robsaddler/BreakBeam/ciseco-master/Ciseco-Eagle-Designs-master/R016 - Slice of Radio/R016 - Slice of Radio v1.1.brd

## EAGLE design ciseco-master/Ciseco-Eagle-Designs-master/R016 - Slice of Radio/R016 - Slice of Radio v1.1.brd (2026-09-29)

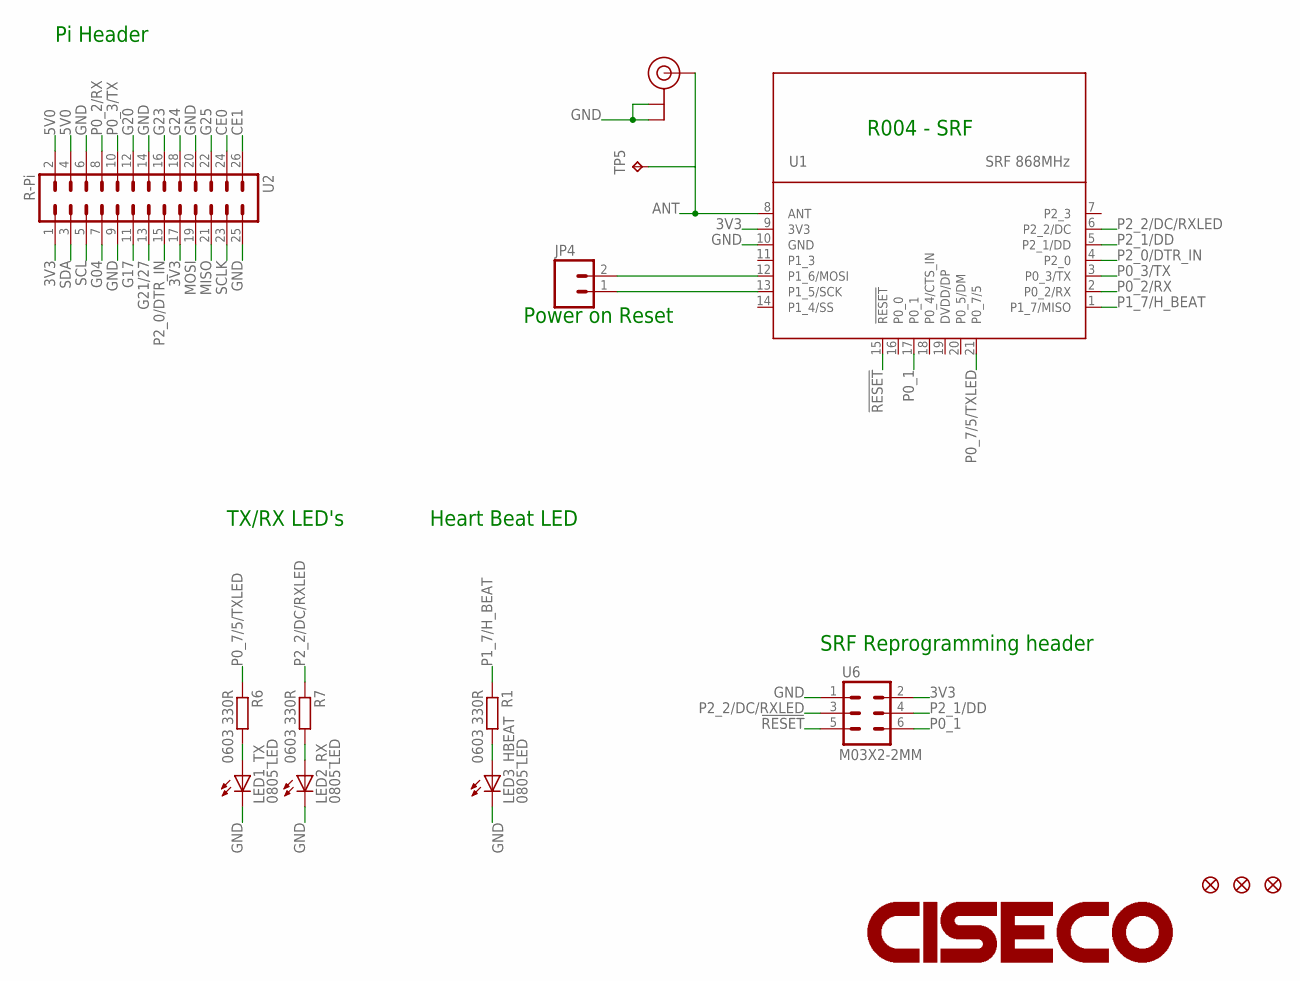
[picture p40: schematic R016 - Slice of Radio v1.1.sch]

Parts:
JP1, JP2, JP3: FIDUCIAL1X2.5-STOP; FIDUCIAL-1X2.5-STOP
JP4: M02PTH; 1X02
LED1_TX, LED2_RX, LED3_HBEAT: 0805 LED; LED-0805-CORRECT
LOGO1: CISECOLOGO-2MM; CISECO-2MM
R1, R6, R7: 0603 330R; C0603K-SMALL
TP5: TPPAD1-13; P1-13
U1: SRF 868MHz; SRF-LANDING-1.2
U2: R-Pi; EVE-BOARD-REF-LOCK
U6: M03X2-2MM; 2X3_2MM
U11: U.FL 868; U.FL

Connections:
3V3: U1.9 (3V3), U2.1, U2.17, U6.2
5V0: U2.2, U2.4
!RESET: U1.15 (!RESET), U6.5
ANT: TP5.TP, U1.8 (ANT), U11.P$3 (SIGNAL)
CE0: U2.24
CE1: U2.26
G04: U2.7
G17: U2.11
G20: U2.12
G21/27: U2.13
G23: U2.16
G24: U2.18
G25: U2.22
GND: LED1_TX.C, LED2_RX.C, LED3_HBEAT.C, U1.10 (GND), U2.6, U2.9, U2.14, U2.20, U2.25, U6.1, U11.P$1 (GND), U11.P$2 (GND)
MISO: U2.21
MOSI: U2.19
unnamed: LED3_HBEAT.A, R1.2
unnamed: JP4.1, U1.13 (P1_5/SCK)
unnamed: JP4.2, U1.12 (P1_6/MOSI)
unnamed: LED2_RX.A, R7.2
unnamed: LED1_TX.A, R6.2
P0_1: U1.17 (P0_1), U6.6
P0_2/RX: U1.2 (P0_2/RX), U2.8
P0_3/TX: U1.3 (P0_3/TX), U2.10
P0_7/5/TXLED: R6.1, U1.21 (P0_7/5)
P1_7/H_BEAT: R1.1, U1.1 (P1_7/MISO)
P2_0/DTR_IN: U1.4 (P2_0), U2.15
P2_1/DD: U1.5 (P2_1/DD), U6.4
P2_2/DC/RXLED: R7.1, U1.6 (P2_2/DC), U6.3
SCL: U2.5
SCLK: U2.23
SDA: U2.3

Notes on the sheet:
Power on Reset
Pi Header
SRF Reprogramming header
TX/RX LED's
Heart Beat LED
R004 - SRF

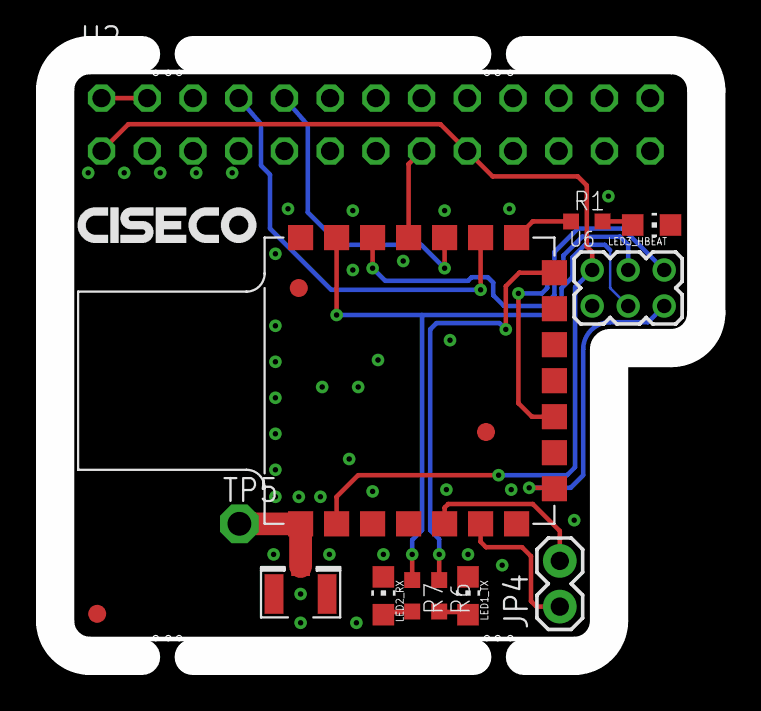
[picture p41: board R016 - Slice of Radio v1.1.brd from above]

Board: 2 copper layers, 36.3 x 33.5 mm, 18 parts (1 on the bottom side), 18 nets.

Other parts of the board:
U$4: WEEE-LOGO
U$5: PIBOW
