robsaddler/BreakBeam/ciseco-master/Ciseco-Eagle-Designs-master/R017 - SRF Shield/R017 - SRF-Shield v1.0.brd

## EAGLE design ciseco-master/Ciseco-Eagle-Designs-master/R017 - SRF Shield/R017 - SRF-Shield v1.0.brd (2026-09-29)

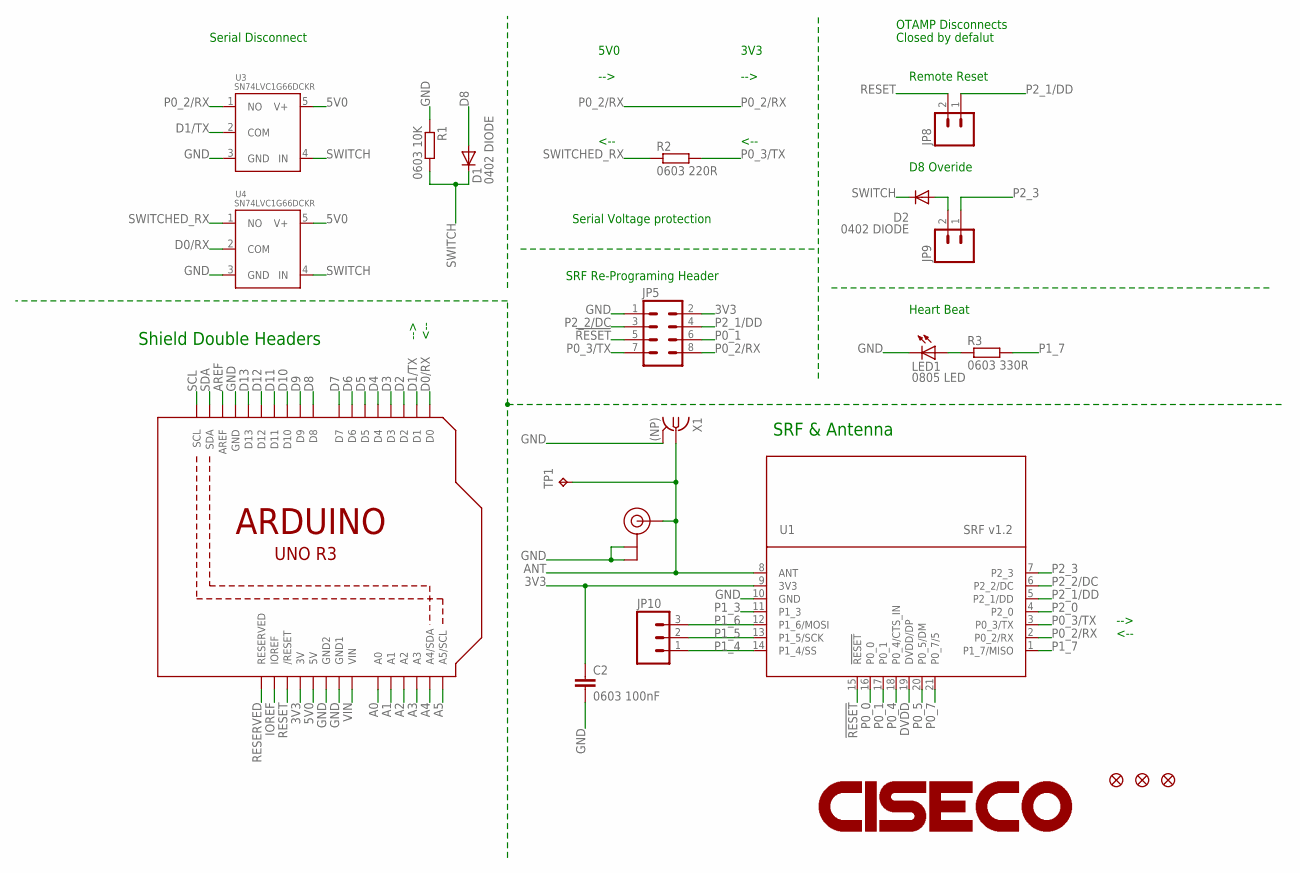
[picture p42: schematic R017 - SRF-Shield v1.0.sch]

Parts:
C2: 0603 100nF; C0402-NARROW
D1, D2: 0402 DIODE; D0402-NARROW
JP4, JP6, JP7: FIDUCIAL1X2.5-STOP; FIDUCIAL-1X2.5-STOP
JP5: M04X2; 2X4
JP8, JP9: M02PTH; 1X02
JP10: M03PTH; 1X03
LED1: 0805 LED; LED-0805-1206
R1: 0603 10K; C0603K-SMALL
R2: 0603 220R; C0603K-SMALL
R3: 0603 330R; C0603K-SMALL
TP1: TPPAD1-13; P1-13
U1: SRF v1.2; SRF-LANDING-1.0A-MOVE
U2: ARDUINOR3-DOUBL-OFFSET; ARDUINOR3-DOUBLE-OFFSET
U3, U4: SN74LVC1G66DCKR; SC70
U5: U.FL (NP); U.FL
U$3: CISECO-LARGE; CISECO-4MM
X1: (NP); J502-ND-142-0711-821/826-LWK1

Connections:
3V3: C2.1, JP5.2, U1.9 (3V3), U2.3V, U2.3V1 (3V)
5V0: U2.5V, U2.5V1 (5V), U3.5 (V+), U4.5 (V+)
!RESET: JP5.5, U1.15 (!RESET)
A0: U2.A0, U2.A6 (A0)
A1: U2.A1, U2.A7 (A1)
A2: U2.A2, U2.A8 (A2)
A3: U2.A3, U2.A9 (A3)
A4: U2.A4 (A4/SDA), U2.A10 (A4/SDA)
A5: U2.A5 (A5/SCL), U2.A11 (A5/SCL)
ANT: TP1.TP, U1.8 (ANT), U5.P$3 (SIGNAL), X1.1
AREF: U2.AREF, U2.AREF1 (AREF)
D0/RX: U2.D0, U2.D18 (D0), U4.2 (COM)
D1/TX: U2.D1, U2.D17 (D1), U3.2 (COM)
D2: U2.D2, U2.D16 (D2)
D3: U2.D3, U2.D15 (D3)
D4: U2.D4, U2.D14 (D4)
D5: U2.D5, U2.D19 (D5)
D6: U2.D6, U2.D20 (D6)
D7: U2.D7, U2.D21 (D7)
D8: D1.A, U2.D8, U2.D22 (D8)
D9: U2.D9, U2.D23 (D9)
D10: U2.D10, U2.D24 (D10)
D11: U2.D11, U2.D25 (D11)
D12: U2.D12, U2.D26 (D12)
D13: U2.D13, U2.D27 (D13)
DVDD: U1.19 (DVDD/DP)
GND: C2.2, JP5.1, LED1.C, R1.1, U1.10 (GND), U2.GND, U2.GND1, U2.GND2, U2.GND3 (GND1), U2.GND4 (GND2), U2.GND5 (GND), U3.3 (GND), U4.3 (GND), U5.P$1 (GND), U5.P$2 (GND), X1.G@1 (GND), X1.G@2 (GND), X1.G@3 (GND), X1.G@4 (GND)
IOREF: U2.IOREF, U2.IOREF1 (IOREF)
unnamed: LED1.A, R3.1
OTAMP_M: D2.A, JP9.2
P0_0: U1.16 (P0_0)
P0_1: JP5.6, U1.17 (P0_1)
P0_2/RX: JP5.8, U1.2 (P0_2/RX), U3.1 (NO)
P0_3/TX: JP5.7, R2.2, U1.3 (P0_3/TX)
P0_4: U1.18 (P0_4/CTS_IN)
P0_5: U1.20 (P0_5/DM)
P0_7: U1.21 (P0_7/5)
P1_3: U1.11 (P1_3)
P1_4: JP10.1, U1.14 (P1_4/SS)
P1_5: JP10.2, U1.13 (P1_5/SCK)
P1_6: JP10.3, U1.12 (P1_6/MOSI)
P1_7: R3.2, U1.1 (P1_7/MISO)
P2_0: U1.4 (P2_0)
P2_1/DD: JP5.4, JP8.1, U1.5 (P2_1/DD)
P2_2/DC: JP5.3, U1.6 (P2_2/DC)
P2_3: JP9.1, U1.7 (P2_3)
RESERVED: U2.RESERVED, U2.RESERVED1 (RESERVED)
RESET: JP8.2, U2.RESET (/RESET), U2.RESET1 (/RESET)
SCL: U2.SCL, U2.SCL1 (SCL)
SDA: U2.SDA, U2.SDA1 (SDA)
SWITCH: D1.C, D2.C, R1.2, U3.4 (IN), U4.4 (IN)
SWITCHED_RX: R2.1, U4.1 (NO)
VIN: U2.VIN, U2.VIN1 (VIN)

Notes on the sheet:
SRF Re-Programing Header
5V0
3V3
Remote Reset
Heart Beat
Closed by defalut
OTAMP Disconnects
Serial Voltage protection
Serial Disconnect
<--
-->
D8 Overide
Shield Double Headers
SRF & Antenna

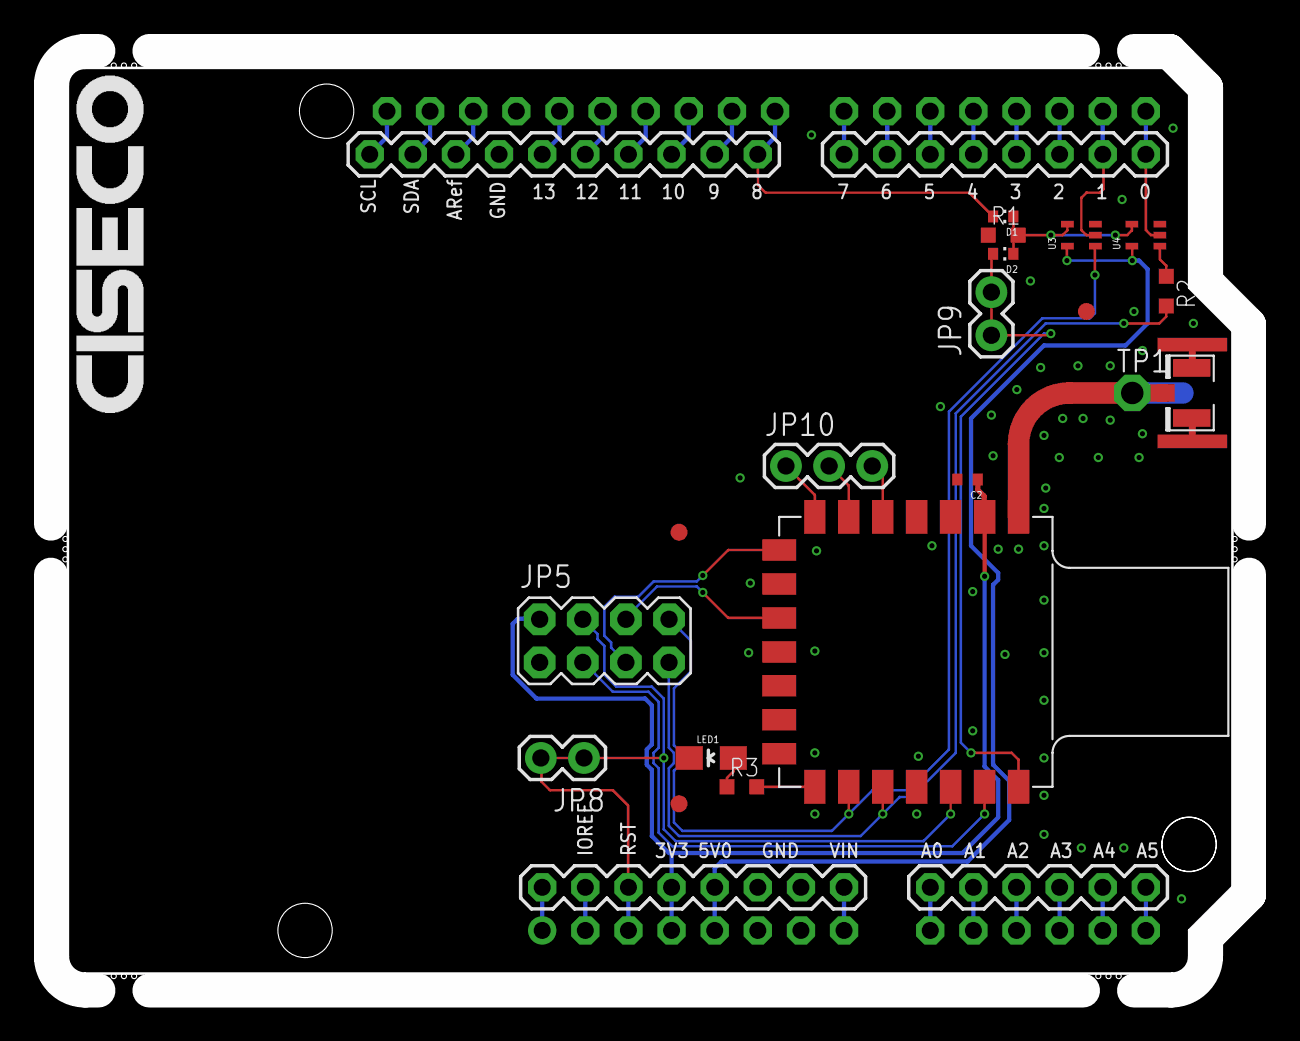
[picture p43: board R017 - SRF-Shield v1.0.brd from above]

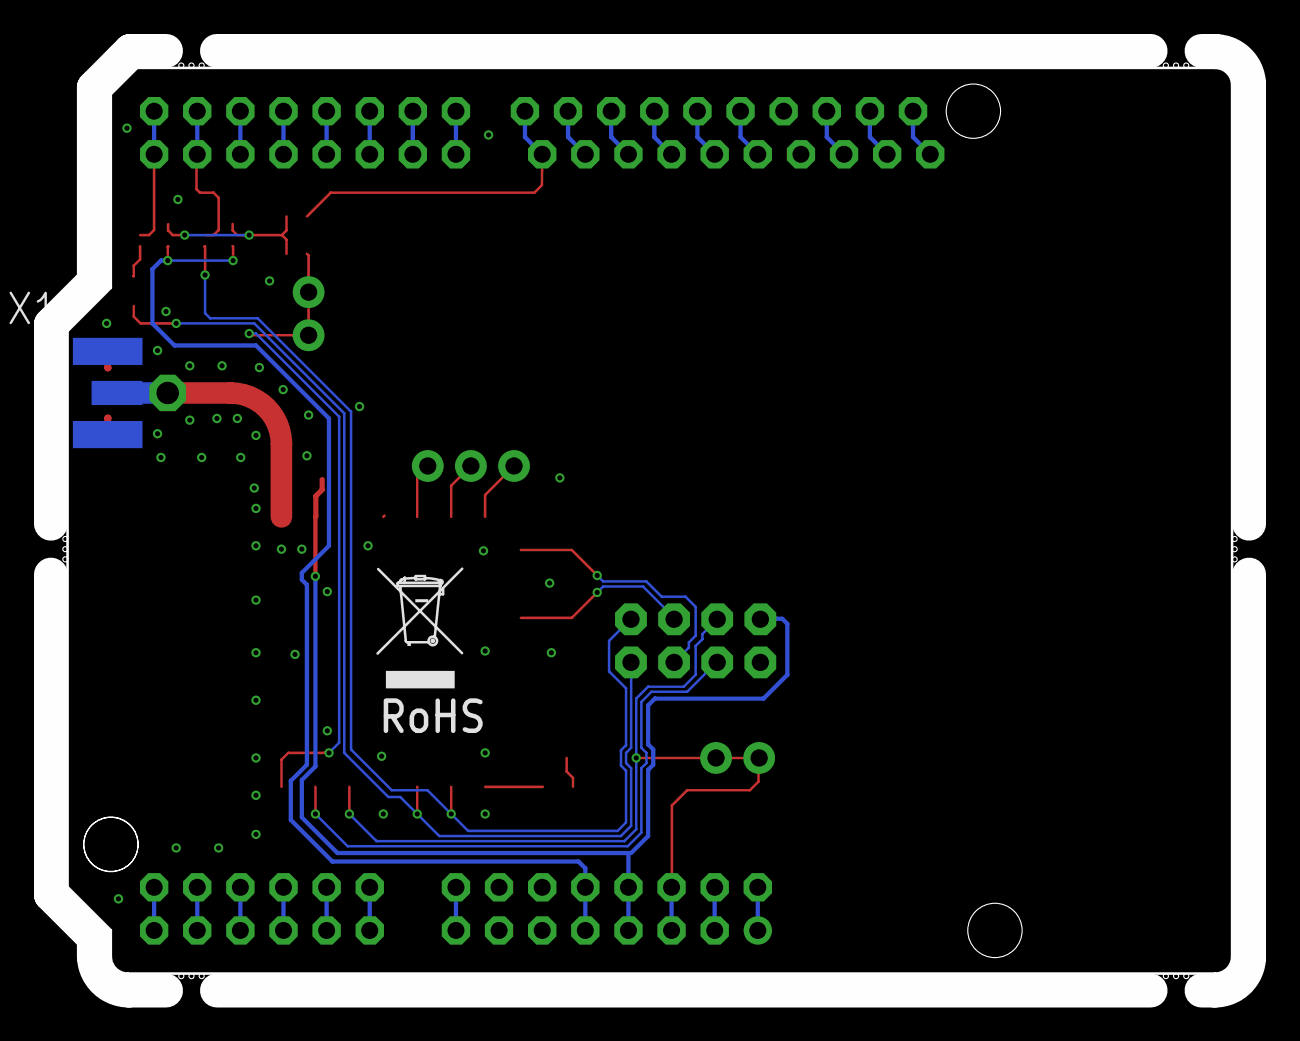
[picture p44: board R017 - SRF-Shield v1.0.brd from below]

Board: 2 copper layers, 70.6 x 55.4 mm, 23 parts (2 on the bottom side), 46 nets.

Other parts of the board:
U$6: WEEE-LOGO
