robsaddler/BreakBeam/ciseco-master/Ciseco-Eagle-Designs-master/B008 - Xino RF/Xino RF v1.3.brd

## EAGLE design ciseco-master/Ciseco-Eagle-Designs-master/B008 - Xino RF/Xino RF v1.3.brd (2026-09-29)

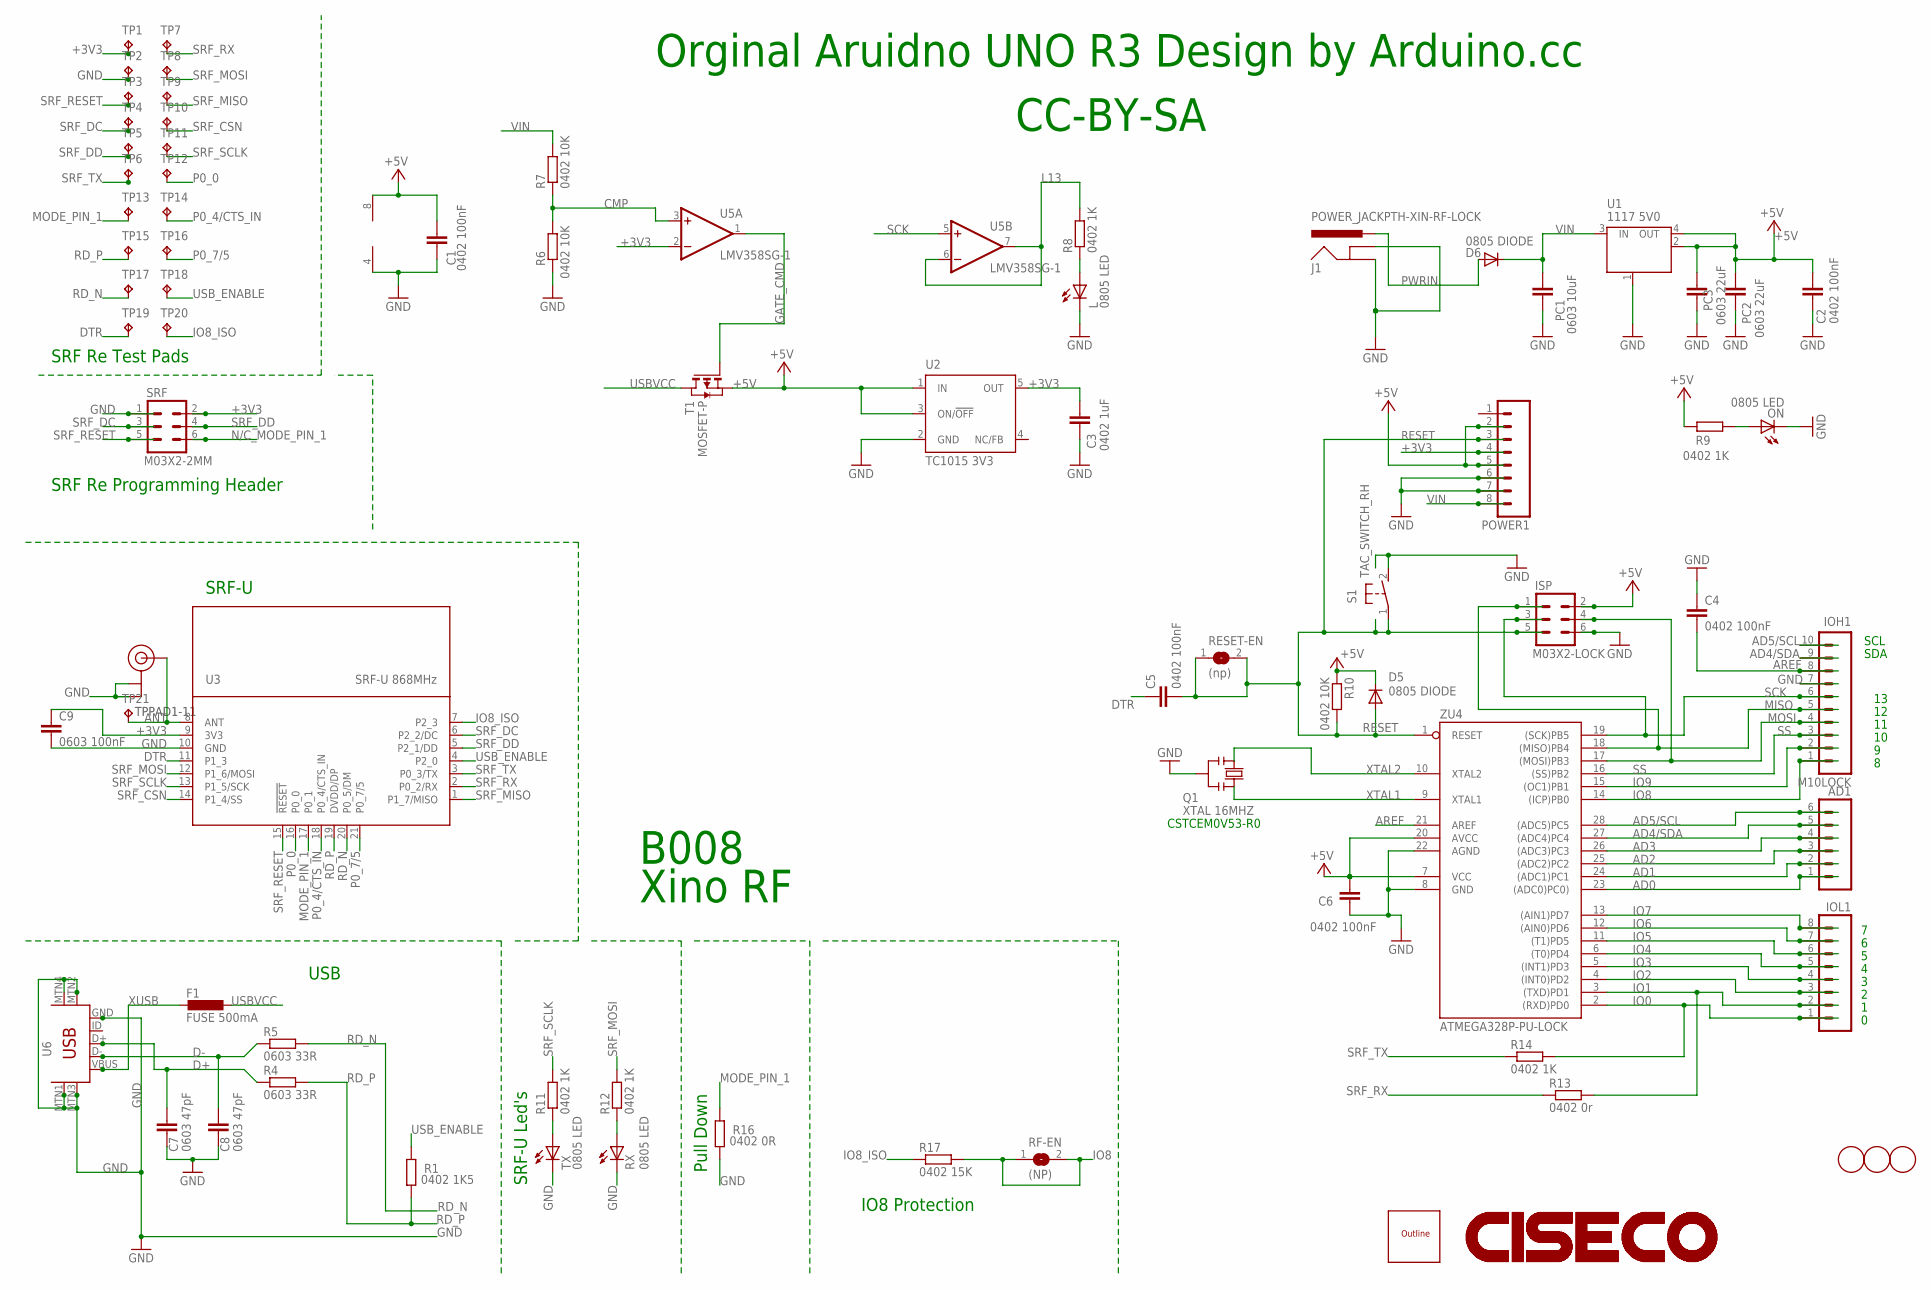
[picture p45: schematic Xino RF v1.3.sch]

Parts:
AD1: M06LOCK; 1X06_LOCK
C1, C2, C4, C5: 0402 100nF; C0402-SMALLER
C3: 0402 1uF; C0402-SMALLER
C6: 0402 100nF; C0603-ROUND
C7, C8: 0603 47pF; C0603K-SMALL
C9: 0603 100nF; C0402-SMALLER
D5, D6: 0805 DIODE; 0805-DIODE
F1: FUSE 500mA; L1812
FD1, FD2, FD3: FIDUCIALMOUNT; FIDUCIA-MOUNT
IOH1: M10LOCK; 1X10_LOCK
IOL1: M08LOCK; 1X08_LOCK
ISP: M03X2-LOCK; 2X3_LOCK
J1: POWER_JACKPTH-XIN-RF-LOCK; POWER_JACK_PTH_XINO_RF_LOCK
L: 0805 LED; LED-0805-1206
ON: 0805 LED; LED-0805-1206
PC1: 0603 10uF; C0805K
PC2, PC3: 0603 22uF; C0805K
POWER1: M08LOCK; 1X08_LOCK
Q1: XTAL 16MHZ; RESONATOR
R1: 0402 1K5; R0402-SMALLER
R4, R5: 0603 33R; C0603K-SMALL
R6, R7, R10: 0402 10K; R0402-SMALLER
R8, R9, R11, R12, R14: 0402 1K; R0402-SMALLER
R13: 0402 0r; R0402-SMALLER
R16: 0402 0R; R0402-SMALLER
R17: 0402 15K; R0402-SMALLER
RESET-EN: (np); SJ
RF-EN: (NP); SJ
RX: 0805 LED; LED-0805-1206
S1: TAC_SWITCH_RH; B3F-31XX
SRF: M03X2-2MM; 2X3_2MM
T1: MOSFET-P; SOT-23
TP1, TP2, TP3, TP4, TP5, TP6, TP7, TP8, TP9, TP10, TP11, TP12, TP13, TP14, TP15, TP16, TP17, TP18, TP19, TP20: TPB1,27; B1,27
TP21: TPPAD1-11; P1-11
TX: 0805 LED; LED-0805-1206
U1: 1117 5V0; SOT223
U2: TC1015 3V3; SOT23-DBV
U3: SRF-U 868MHz; SRF-LANDING-1.2
U5: LMV358SG-1; SO08
U6: USB-MINIB-5PIN; USB-MINIB-CISECO-1
U11: U.FL 868; U.FL
U$1: CISECO-MEDIUM; CISECO-1.3MM
U$2: ARDUINO-OUTLINE-MILL
U$3: CISECO-LARGE; CISECO-4MM
ZU4: ATMEGA328P-PU-LOCK; DIL28-3-LOCK

Connections:
+3V3: C3.2, C9.1, POWER1.4, SRF.2, TP1.TP, U2.5 (OUT), U3.9 (3V3), U5.2 (-IN)
+5V: C1.2, C2.2, C6.2, D5.C, ISP.2, PC2.1, PC3.1, POWER1.2, POWER1.5, R9.2, R10.1, T1.2 (S), U1.2 (OUT), U1.4 (OUT), U2.1 (IN), U2.3 (ON/!OFF), U5.8 (V+), ZU4.7 (VCC), ZU4.20 (AVCC)
AD0: AD1.1, ZU4.23 ((ADC0)PC0))
AD1: AD1.2, ZU4.24 ((ADC1)PC1)
AD2: AD1.3, ZU4.25 ((ADC2)PC2)
AD3: AD1.4, ZU4.26 ((ADC3)PC3)
AD4/SDA: AD1.5, IOH1.9, ZU4.27 ((ADC4)PC4)
AD5/SCL: AD1.6, IOH1.10, ZU4.28 ((ADC5)PC5)
ANT: TP21.TP, U3.8 (ANT), U11.P$3 (SIGNAL)
AREF: C4.2, IOH1.8, ZU4.21 (AREF)
CMP: R6.2, R7.1, U5.3 (+IN)
D+: C7.1, R4.1, U6.D+
D-: C8.1, R5.1, U6.D-
DTR: C5.1, TP19.TP, U3.11 (P1_3)
GATE_CMD: T1.3 (G), U5.1 (OUT)
GND: C1.1, C2.1, C3.1, C4.1, C6.1, C7.2, C8.2, C9.2, IOH1.7, ISP.6, J1.GND, J1.GNDBREAK, L.C, ON.C, PC1.2, PC2.2, PC3.2, POWER1.6, POWER1.7, Q1.2, R6.1, R16.1, RX.C, S1.2 (S), SRF.1, TP2.TP, TX.C, U1.1 (GND/ADJ), U2.2 (GND), U3.10 (GND), U5.4 (V-), U6.GND, U6.MTN1 (MTN2), U6.MTN2 (MTN3), U6.MTN3 (MTN1), U6.MTN4, U11.P$1 (GND), U11.P$2 (GND), ZU4.8 (GND), ZU4.22 (AGND)
IO0: IOL1.1, R14.2, ZU4.2 ((RXD)PD0)
IO1: IOL1.2, R13.2, ZU4.3 ((TXD)PD1)
IO2: IOL1.3, ZU4.4 ((INT0)PD2)
IO3: IOL1.4, ZU4.5 ((INT1)PD3)
IO4: IOL1.5, ZU4.6 ((T0)PD4)
IO5: IOL1.6, ZU4.11 ((T1)PD5)
IO6: IOL1.7, ZU4.12 ((AIN0)PD6)
IO7: IOL1.8, ZU4.13 ((AIN1)PD7)
IO8: IOH1.1, R17.2, RF-EN.1, RF-EN.2, ZU4.14 ((ICP)PB0)
IO8_ISO: R17.1, TP20.TP, U3.7 (P2_3)
IO9: IOH1.2, ZU4.15 ((OC1)PB1)
L13: R8.2, U5.6 (-IN), U5.7 (OUT)
MISO: IOH1.5, ISP.1, ZU4.18 ((MISO)PB4)
MODE_PIN_1: R16.2, TP13.TP, U3.17 (P0_1)
MOSI: IOH1.4, ISP.4, ZU4.17 ((MOSI)PB3)
unnamed: L.A, R8.1
unnamed: ON.A, R9.1
unnamed: R12.1, RX.A
unnamed: R11.1, TX.A
N/C_MODE_PIN_1: SRF.6
P0_0: TP12.TP, U3.16 (P0_0)
P0_4/CTS_IN: TP14.TP, U3.18 (P0_4/CTS_IN)
P0_7/5: TP16.TP, U3.21 (P0_7/5)
PWRIN: D6.A, J1.PWR
RD_N: R5.2, TP17.TP, U3.20 (P0_5/DM)
RD_P: R1.1, R4.2, TP15.TP, U3.19 (DVDD/DP)
RESET: C5.2, D5.A, ISP.5, POWER1.3, R10.2, RESET-EN.1, RESET-EN.2, S1.1, ZU4.1 (RESET)
SCK: IOH1.6, ISP.3, U5.5 (+IN), ZU4.19 ((SCK)PB5)
SRF_CSN: TP10.TP, U3.14 (P1_4/SS)
SRF_DC: SRF.3, TP4.TP, U3.6 (P2_2/DC)
SRF_DD: SRF.4, TP5.TP, U3.5 (P2_1/DD)
SRF_MISO: TP9.TP, U3.1 (P1_7/MISO)
SRF_MOSI: R12.2, TP8.TP, U3.12 (P1_6/MOSI)
SRF_RESET: SRF.5, TP3.TP, U3.15 (!RESET)
SRF_RX: R13.1, TP7.TP, U3.2 (P0_2/RX)
SRF_SCLK: R11.2, TP11.TP, U3.13 (P1_5/SCK)
SRF_TX: R14.1, TP6.TP, U3.3 (P0_3/TX)
SS: IOH1.3, ZU4.16 ((SS)PB2)
USBVCC: F1.1, T1.1 (D)
USB_ENABLE: R1.2, TP18.TP, U3.4 (P2_0)
VIN: D6.C, PC1.1, POWER1.8, R7.2, U1.3 (IN)
XTAL1: Q1.3, ZU4.9 (XTAL1)
XTAL2: Q1.1, ZU4.10 (XTAL2)
XUSB: F1.2, U6.VBUS

Notes on the sheet:
Xino RF
SDA
SCL
Pull Down
IO8 Protection
CC-BY-SA
Orginal Aruidno UNO R3 Design by Arduino.cc
USB
SRF Re Programming Header
SRF Re Test Pads
SRF-U
SRF-U Led's
B008
CSTCEM0V53-R0

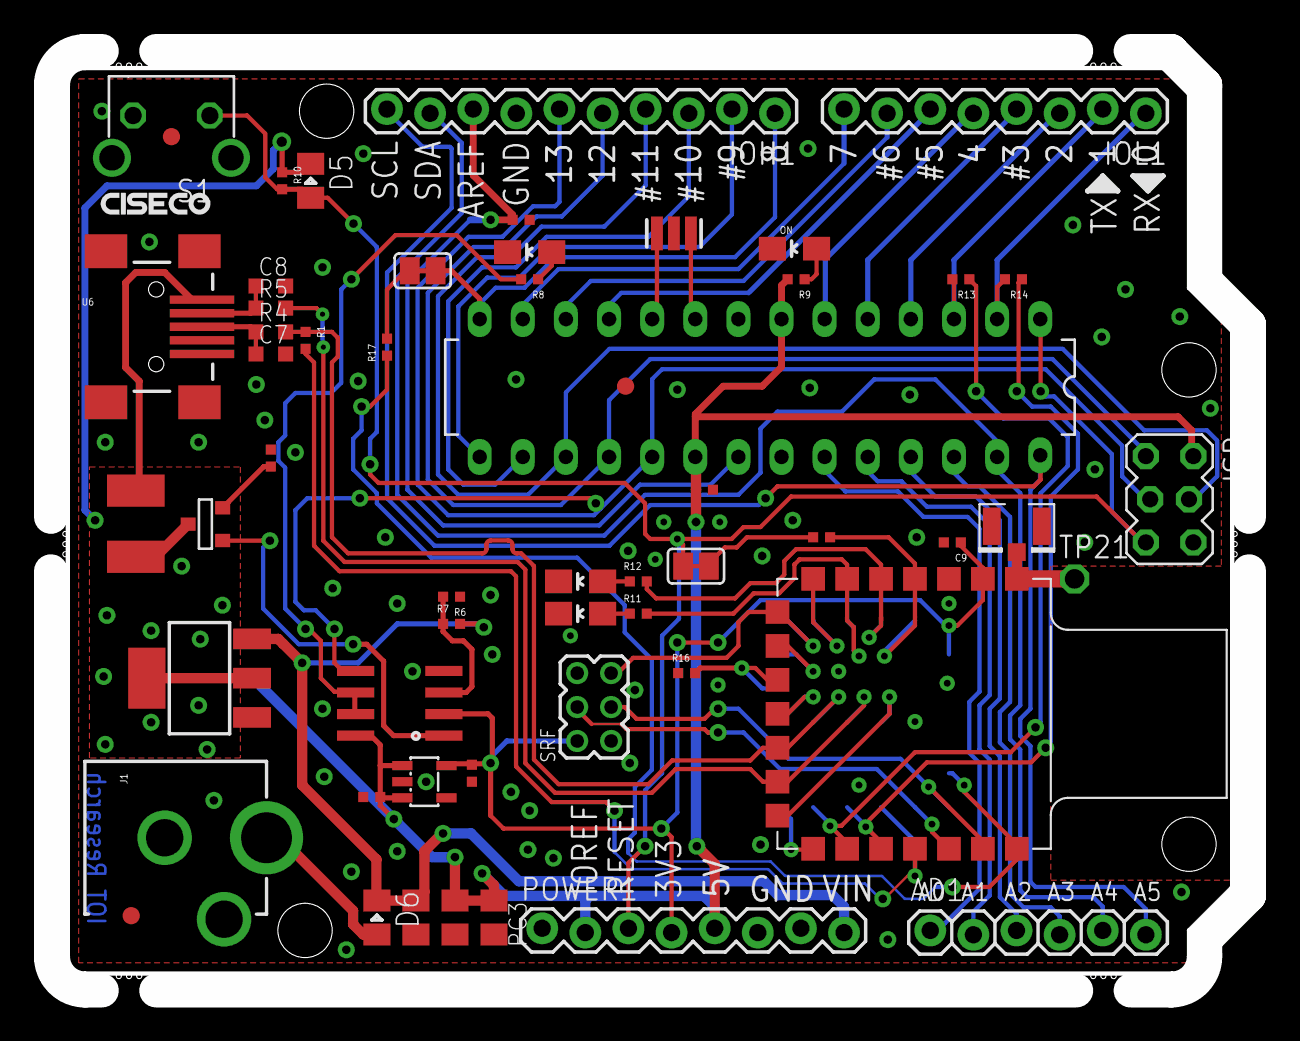
[picture p46: board Xino RF v1.3.brd from above]

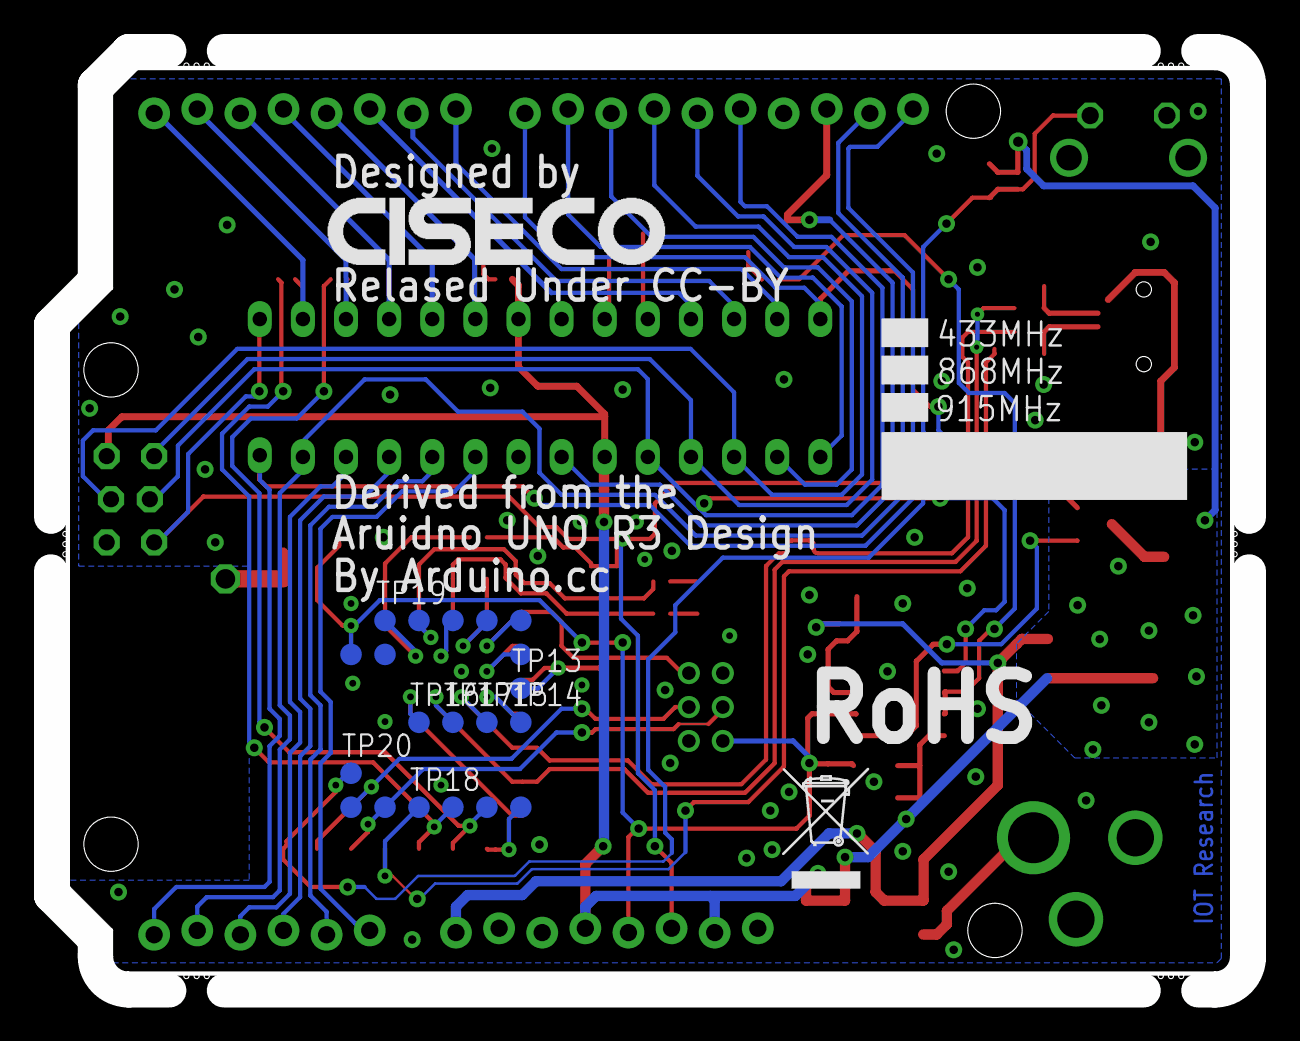
[picture p47: board Xino RF v1.3.brd from below]

Board: 2 copper layers, 70.6 x 55.4 mm, 80 parts (22 on the bottom side), 59 nets.

Other parts of the board:
U$4: WEEE-LOGO
