robsaddler/BreakBeam/(commit log)

2026-09-29 BreakBeam speed gates: firmware, PlatformIO project, build guide, Ciseco docs
    Phase 1 (radio link) verified 2026-09-28: both R017 SRF shields self-test OK
    at 115200 baud, finish gate polls start gate with 15-16 ms round trip.
    - BreakBeam/BreakBeam.ino: one firmware for both gates; role (start/finish)
    set once over USB serial and kept in EEPROM. Finish gate polls the start
    gate with 12-byte radio frames and places the start event on its own clock
    from the reported event age, so no clock sync is needed.
    - platformio.ini: builds the same sketch; also opens in Arduino IDE.
    - tools/gate.ps1: send commands to a gate and watch its output.
    - docs/GUIDE.md: beginner build guide, phase by phase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
    [R016 - Slice of Radio v1.1.brd, R016 - Slice of Radio v1.1.sch, R017 - SRF-Shield v1.0.brd, R017 - SRF-Shield v1.0.sch, Xino RF v1.3.brd, Xino RF v1.3.sch]
2026-09-30 Add solo role (both beams on one board) and four display drivers
    Phase 3 is blocked until stackable headers are soldered to the shields, because
    they have no sockets on top: a fitted shield leaves nowhere to plug a jumper.
    Solo role sidesteps that so the sensing and timing can be tested tonight.
    - role solo: A0 is the start beam, A1 the finish, joined by a long cable. The
    radio is left alone entirely, so no shield is needed. Lap mode still works for
    a single sensor.
    - BeamSensor is now a class, so two instances can watch two pins.
    - Displays, selected by "display <type>" and kept in EEPROM: 16x2 parallel LCD,
    16x2 on an I2C backpack (address auto-detected), TM1637 4-digit, MAX7219
    8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
2026-09-30 Phase 3 needs no soldering: the shield only uses six Arduino pins
    Read from the R017 schematic netlist in ciseco-master/: the SRF radio is wired to
    3V3, 5V, GND, D0, D1 and D8 only. Every other Arduino pin on the shield is a bare
    pass-through with nothing attached, so the shield does not have to sit on the Uno.
    Six female-to-male jumpers from the shield's pins to the Uno free every other pin
    for sensors and a display, which unblocks the two-gate build before the stackable
    headers arrive.
    Also recorded: the shield cannot go into a breadboard (pin rows ~48 mm apart
    against a breadboard's ~23 mm span, and the R3 half-pitch offset on the D8 row),
    and the footprint is ARDUINOR3-DOUBLE-OFFSET, so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
2026-10-03 Phase 2 rewritten around the parts in photos/, LCD data pins straight through
    Photos identified: a 1602A V2.0 with its 16-pin header already soldered (so it
    plugs into a breadboard with no soldering), a bare 2004A 20x4 and a bare 4-digit
    7-segment (both need soldering, so both skipped), several LDRs, three buzzers of
    unknown type, a Prototype Shield v.5, and Class III laser pens at 532 nm green
    and 650 nm red.
    - Firmware: the parallel LCD data pins were crossed over (LCD D4-D7 to Arduino
    D5-D2), which is easy to miswire by hand. Now straight through: LCD D4-D7 to
    Arduino D2-D5.
    - docs/GUIDE.md Phase 2 rewritten as a stage-by-stage bench build for those exact
    parts: laser safety, bread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
    [BreakBeam.ino]
2026-10-03 Phase 2 leads with the TEPT5700, not the LDR
    Starting on the LDR was over-cautious: neither sensor had been tested on this
    hardware, so the LDR was not a known-good baseline, and the firmware treats the
    two identically. Leading with the LDR just meant tuning the thresholds twice.
    - Parts table and Stage 3 now specify the phototransistor, including the polarity
    (long leg to the positive rail) that the LDR does not have, and the reassurance
    that reversed legs only give a dull reading because the 10k limits the current.
    - Stage 5 gains a table of expected readings. Pinned at 1023 with the laser on is
    correct and wanted, since the firmware only looks for a sudden fall; the case
    that nee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
2026-10-03 Add a plain-English glossary; the guide assumed terminology it should not
    Rob flagged that "jumper from the Uno's 5V to the + rail" assumes vocabulary he
    has never met. The guide was written at the wrong level in places, so it now
    opens with a glossary defining every term it uses before using it: jumper wire
    (and male vs female ends), breadboard, rail, row, pin, leg, GND, 5V, the analogue
    and digital pins, polarity, resistor colour bands, LDR, phototransistor,
    potentiometer, flashing, serial monitor, baud and firmware.
    Phase 2's breadboard explainer now points at the glossary rather than repeating a
    partial version of it.
2026-10-03 Use 330 ohm instead of 220 ohm, and say how exact resistor values must be
    Rob's assortment runs 10, 22, 47, 100, 150, 330, 470 and decade multiples, with no
    220 ohm in it. Every 220 ohm in the guide and the firmware comments is now 330 ohm,
    which he has.
    The guide also now says how close these values need to be, because it never did:
    the backlight and indicator-LED resistors only limit current, so anything from
    about 150 to 470 ohm works and the value just sets brightness. Only the sensor
    divider's 10 kohm affects behaviour, and that is adjustable too. The resistor
    colour-band table gained the values actually used: 150, 330, 470, 1k, 4.7k, 10k.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
2026-10-03 Stop naming an arbitrary breadboard row for the sensor
    "Row 10" was only ever an example, but the guide never said so, and Rob spotted
    that one of the LCD's own pins had landed in his row 10. Sharing that row would
    have wired the sensor's output straight onto an LCD data pin.
    The sensor connections are now described as "the sensor row", defined as any
    completely empty row, with the rule stated plainly: those three things share it
    and nothing else may be in it. The glossary entry for "row" now leads with the
    same rule, and adds that the channel down the middle splits every row in two, so
    the same number above and below it are separate rows.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
2026-10-03 Add a multimeter section, including that probe tips do not fit breadboard holes
    Debugging a dark LCD exposed two gaps. The guide told Rob to measure voltages
    without ever explaining how to set the meter up, and then told him to push the
    probe tips into breadboard holes, which does not work: a tip is about 2 mm across
    against a 0.6 mm hole, so it never reaches the clip inside and reads a false zero,
    and forcing it splays the clip and ruins the row.
    New section covers lead placement and the DC volts position, the warning about
    the A and mA sockets, using a spare jumper wire as a test point, the rule that
    voltage needs the power on while resistance and continuity need it off, and what
    a flat b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
2026-10-03 Fix the display test value, and separate the contrast and backlight circuits in the guide
    The "t" command said it was sending 12.34 but actually sent 1,234,000 microseconds,
    which the display correctly rendered as 1.23. The message was wrong, not the
    display. Now sends 12.34 s, which also exercises the tens digit.
    The guide listed the contrast pot and the backlight resistor adjacently in the pin
    table without saying they are independent circuits, so Rob wired LCD pin 15 to a
    pot leg. That feeds the backlight through the pot's whole 50k track, which passes
    so little current the screen stays dark and pin 15 reads near 0 V. The guide now
    draws the two circuits separately and says what that mis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
    [BreakBeam.ino]
2026-10-03 Phase 2 passed: first real times from the hardware
    On the board marked "start" (COM4), with a TEPT5700 and a 10k resistor: the beam
    reads 1022 with the red 650 nm laser on it and about 181 blocked, against roughly
    190 in room light alone. Three hand-waved lap times came out at 1.410 s, 0.821 s
    and 1.480 s, so the whole chain works end to end - laser, phototransistor,
    threshold, microsecond timing, LCD and serial.
    Also in this commit: "t" now re-initialises the display before testing, because a
    garbled screen is almost always one that lost its setup, and that gives a one-key
    fix. The guide records the measured numbers and two things that look like faults
    but are not: the sensor reads low in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
    [BreakBeam.ino]
2026-10-03 Make the single gate usable without a PC, and stop the display fighting back
    A long bench session on one gate turned up several real faults, all fixed here.
    - A beam that was never present could be "broken". An unconnected analogue pin
    drifts and mirrors its neighbour, so A1 stopped the clock the instant A0 started
    it, giving 0.000 s. A break now requires the beam to have been there first.
    - Lap mode was lost on every reset, and opening the serial port resets the board,
    so it kept turning itself off. Now kept in EEPROM.
    - Lap mode restarted the clock on the same break that stopped it, so the result
    was wiped after a single frame and could never be read. It now stops and holds;
    the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
    [BreakBeam.ino]
2026-10-03 Always drive D8; a floating radio-enable corrupts serial and blocks uploads
    With a shield attached, leaving D8 as an input leaves the two TS5A1066 analogue
    switches half open. That couples the radio onto the D0/D1 lines it shares with
    USB, mangling characters in both directions, so commands were silently lost and
    avrdude could not talk to the bootloader at all.
    The firmware only ever set D8 in the start and finish roles, so solo mode left it
    floating. It is now always an output: high when the radio is wanted, low
    otherwise. Recovery if you meet it on an older build: pull the D0 and D1 jumpers,
    upload, reconnect.
    Gate two is complete with this: radio self-test passes at 115200 over six
    fema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
2026-10-03 Phase 3 passed: first wireless start-to-finish time
    Two gates, two lasers, two phototransistors, a radio link and a display. The start
    event crossed the room by radio and was placed on the finish gate's clock to within
    8 ms; the first full time came out at 4.095 s with the link at 16 ms round trip.
    Both shields are connected by six female-to-male jumpers, so no soldering was
    needed after all.
    Lap mode is now a solo-role feature only. The finish gate has a start gate to
    listen to, so timing its own beam twice was never meaningful, and worse, the
    setting could not be turned off reliably: a command typed at the finish gate
    shares the serial line with ten radio polls a second and is usually shr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
2026-10-03 Fix a timer underflow that abandoned every run on the tick it started
    finishGateLoop sampled millis() at the top of the iteration, then a radio reply
    arriving later in the same iteration stamped runStartMs with a fresh millis().
    When a millisecond ticked over in between, the start was fractionally ahead of the
    loop's own clock and "nowMs - runStartMs" wrapped to about four billion, sailing
    past the sixty second limit and binning the run immediately. The symptom was a
    gate that announced "START! clock running" and was back to ARMED on the next line,
    intermittently, because it depended on exactly when the millisecond boundary fell.
    All the elapsed-time tests in both loops now go through an el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
    [BreakBeam.ino]
2026-10-03 Add Phase 4: the permanent build, written to be designed around
    Moves each gate off the breadboard onto a soldered prototype shield in a vertical
    stack, specified in enough detail that a case can be modelled around it.
    - Stack order is Uno, prototype shield, SRF radio on top. The radio goes on top
    because its own datasheet warns that covering the antenna section cuts range,
    and that order also means nothing stacks above it, so the stackable headers are
    not needed at all.
    - Guiding rule for the shield layout: anything that has to point somewhere lives
    on a lead, not on the board. Sockets rather than soldered-in components wherever
    a part might fail.
    - Power is one 9 V PP3 per gate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
2026-10-03 Rework Phase 4 for four tripods: a through-beam gate is four boxes, not two
    Rob has four tripods and is putting the laser on one and the Arduino on the other,
    across the lane. That is a through-beam gate, the arrangement commercial timing
    gates use and the more reliable of the two, but it invalidates the advice I had
    just written, which assumed laser and sensor shared a bracket.
    - Each gate is now two boxes: a sensor box with all the electronics, and a laser
    box containing only a laser, a battery and a switch.
    - The laser box must carry its own power. A cable across the lane is a trip hazard
    at hip height in front of sprinting athletes, so that is stated as a hard rule
    rather than a p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
2026-10-03 Laser end is a printed clamp for the existing pens, not a bought module
    Rob is keeping the laser pens, which already carry their own batteries. That makes
    each laser box simpler than what I had written: no module to buy, no battery, no
    switch, no electronics at all. Just a clamp with a tripod thread.
    The design note that matters is that the clamp should press the pen's button
    itself, via a thumbscrew bearing on it, which doubles as a genuine on/off control.
    Tape was what kept slipping during bench testing, and a printed part can do that
    job properly.
    Also specified: a split clamp with a pinch screw rather than a printed hole sized
    to grip, since a hole comes out a few tenths wrong and anyt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
2026-10-17 Give each event its own sound, and stop the tunes blocking the loop
    Rob has no buzzer wired yet and asked for start and finish to be audibly obvious
    rather than two similar beeps. The old scheme was 1500 Hz against 2000 Hz for
    60 ms against 80 ms, which is not tellable apart across a track.
    Events now have shapes rather than pitches: a rising fifth C6 to G6 means
    something has begun, the same fifth falling means it has finished, a climbing
    C6-G6-C7 means a time is ready, and two flat notes mean nothing happened. The
    finish gate also plays the start sound when the radio reports the far gate firing,
    so a coach standing at the finish hears the whole run: rising as they go, falling
    as they arri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
2026-10-28 Send the result back to the start gate so a screen there can show it
    The start gate never learns a time. It only knows its own beam broke; the finish
    gate does the arithmetic. A third frame now carries the answer back:
    "@T<run2><hundredths6>-", the same 12 bytes as the other two so the SRF sends it
    at once rather than holding it for a 16 ms timeout.
    Two things about how it is sent. It is queued rather than fired on the spot, and
    goes out only when the finish gate is not awaiting a reply, because the radio is
    half duplex and transmitting while the start gate was mid-reply would collide. And
    it repeats three times, since nothing acknowledges it and one lost frame would
    leave a stale time on t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
2026-10-29 Record the direction change to ESP32 in the project README
    Nothing has been soldered, so no work is lost. Noting here why the swap is worth
    making, since the reason is not the web app that prompted it: the Uno has one
    serial port shared between the radio and USB, and that is the root of most of the
    bugs this project has hit. An ESP32 has three, so the radio gets one to itself.
    Also records what carries over, which is nearly everything, and what is on hold:
    the prototype-shield assembly, and the case design, which was sized around a
    three-board stack that will no longer exist.
2026-10-29 Add the ESP32 bench test sketch and fix the pin map for a 30-pin DOIT board
    First code for the new board. Deliberately does three things and no more: proves
    the ESP32 flashes and talks to the PC, reads the beam sensor, and gets the SRF to
    answer on a serial port of its own. No timing logic until those three pass.
    Three constraints fixed the pin map. The sensors must sit on ADC1, because the
    other analogue bank stops working the moment wifi is on and wifi is the point of
    the exercise. GPIO 0, 2, 5, 12 and 15 decide how the chip boots, so nothing is
    wired to them; a display on one of those gives a board that sometimes will not
    start, which is a horrible fault to chase. And 21 and 22 are left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
