robsaddler/BreakBeam/(notices)

Notices in the files:
ciseco-master/Ciseco-Eagle-Designs-master/B008 - Xino RF/Xino RF v1.3.brd:
Relased Under CC-BY
parts and their libraries:
SparkFunJan12: Licensing: CC v3.0 Share-Alike You are welcome to use this library for commercial purposes.
