robsaddler/BreakBeam/photos/PXL_20261003_113512550.jpg

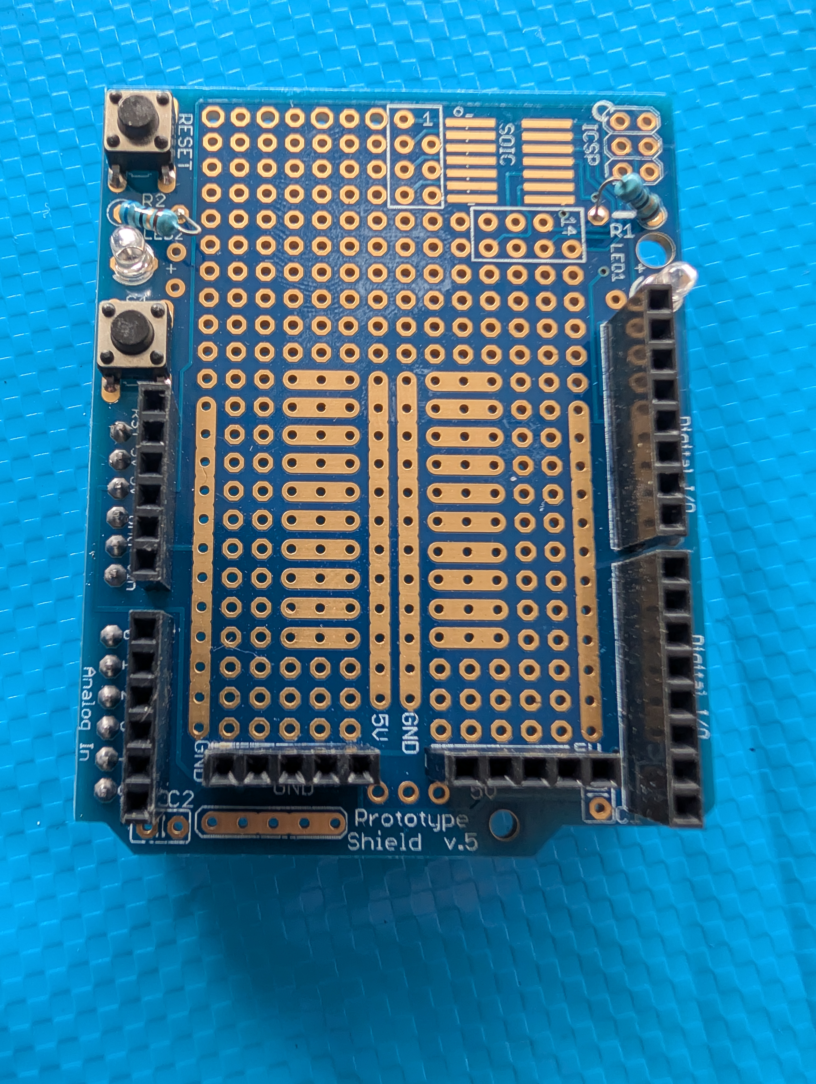
photos/PXL_20261003_113512550.jpg
