robsaddler/BreakBeam/photos/PXL_20261003_113529366.jpg

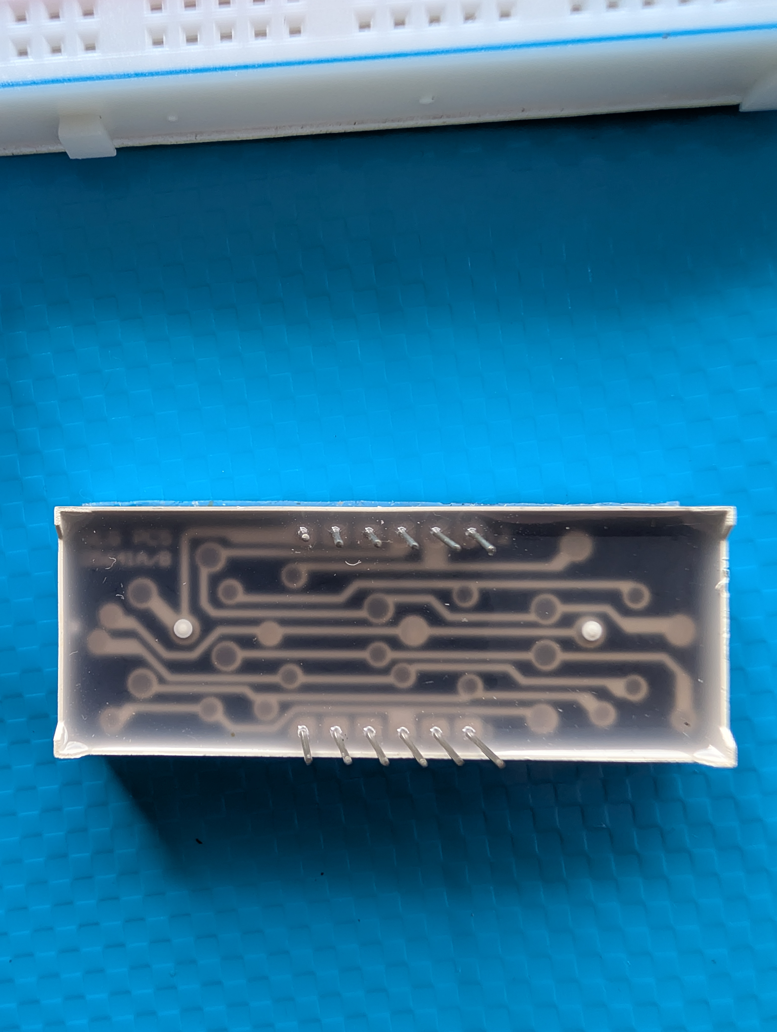
photos/PXL_20261003_113529366.jpg
