robsaddler/BreakBeam/photos/PXL_20261003_113542132.jpg

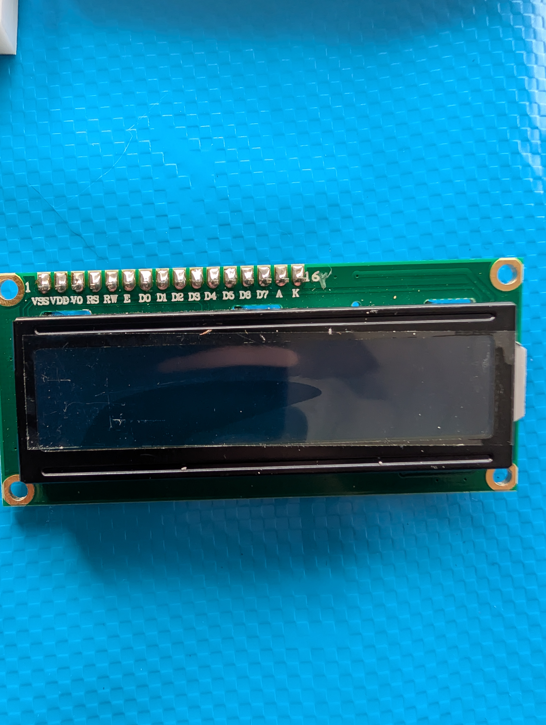
photos/PXL_20261003_113542132.jpg
