robsaddler/BreakBeam/photos/PXL_20261003_113548485.jpg

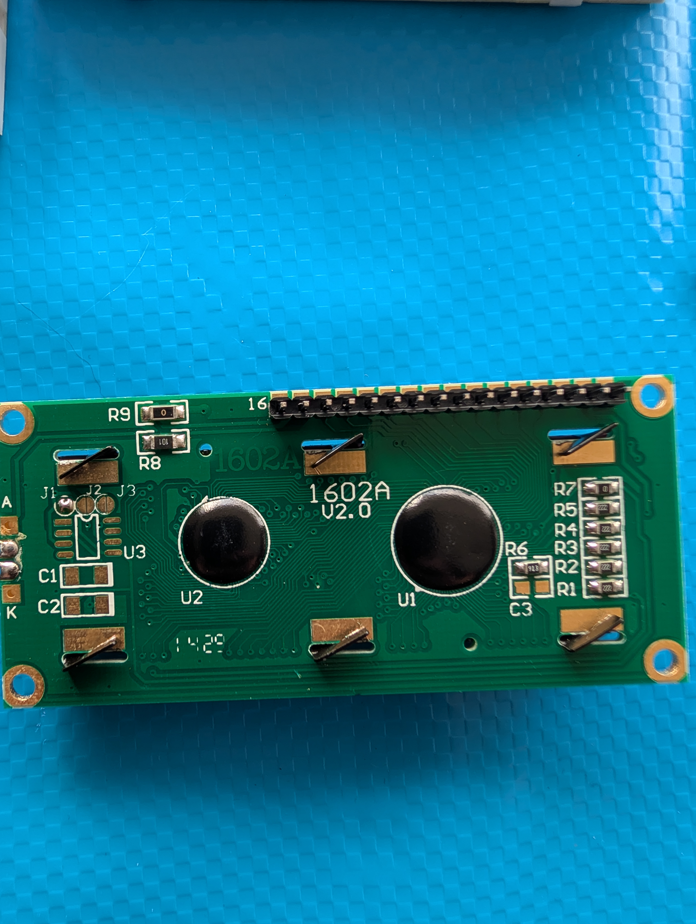
photos/PXL_20261003_113548485.jpg
