robsaddler/BreakBeam/photos/PXL_20261003_113816968.jpg

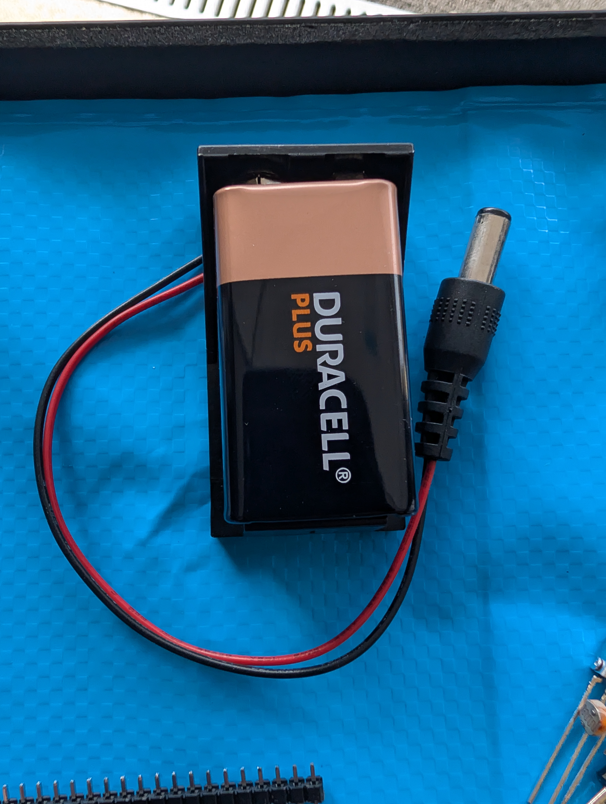
photos/PXL_20261003_113816968.jpg
