robsaddler/BreakBeam/photos/PXL_20261003_113824760.jpg

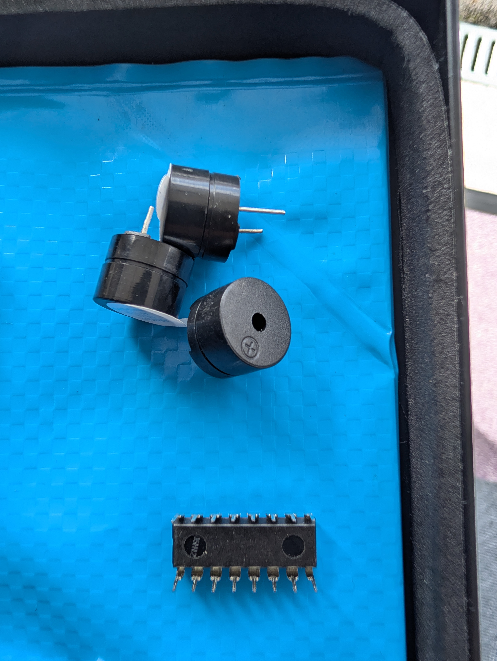
photos/PXL_20261003_113824760.jpg
