robsaddler/BreakBeam/photos/PXL_20261003_113829189.jpg

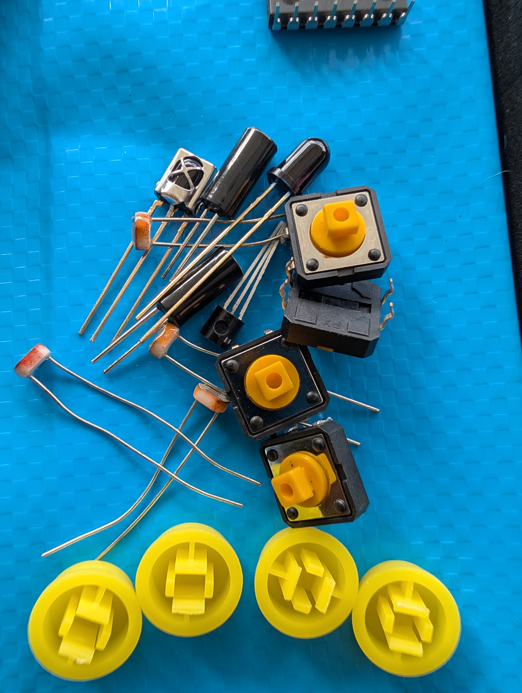
photos/PXL_20261003_113829189.jpg
