robsaddler/BreakBeam/photos/PXL_20261003_113833670.jpg

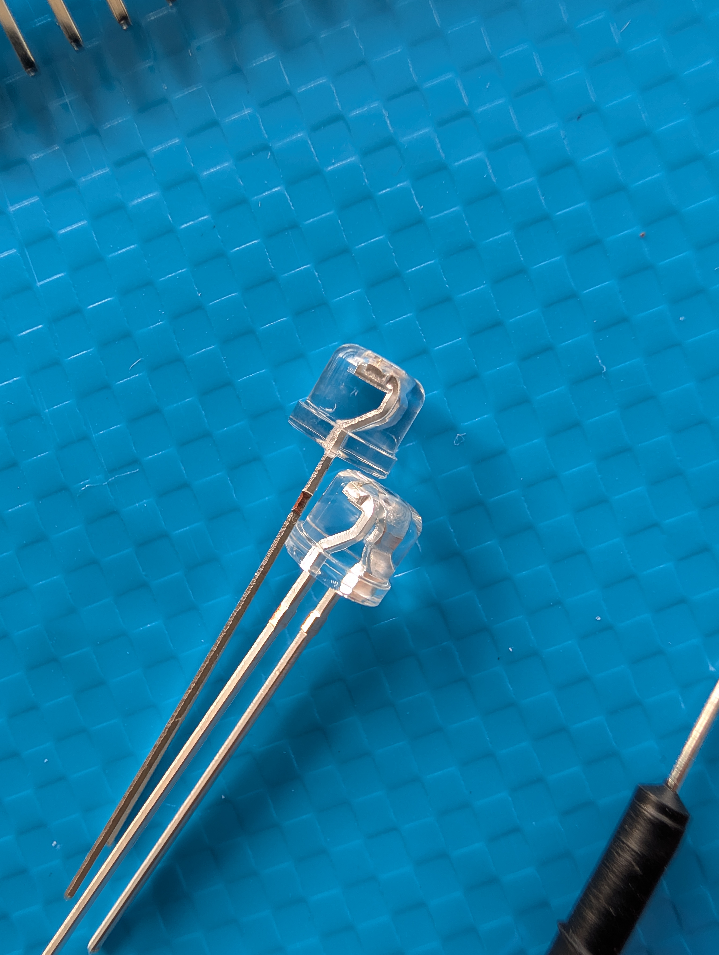
photos/PXL_20261003_113833670.jpg
