robsaddler/BreakBeam/photos/PXL_20261003_113836710.jpg

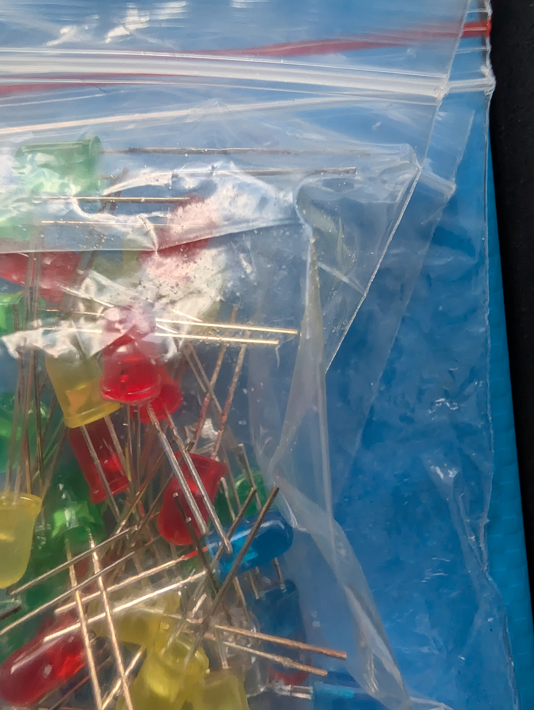
photos/PXL_20261003_113836710.jpg
