robsaddler/BreakBeam/photos/PXL_20261003_113850774.jpg

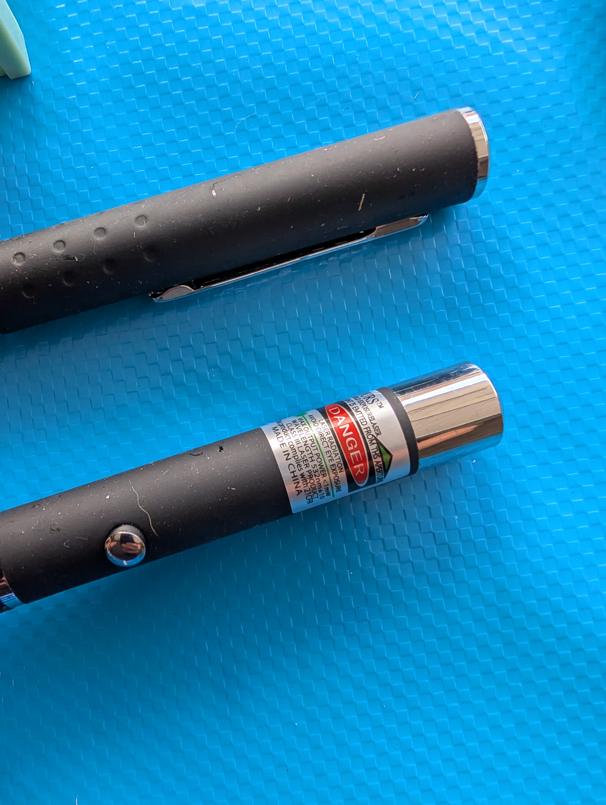
photos/PXL_20261003_113850774.jpg
