robsaddler/BreakBeam/photos/PXL_20261003_113854789.jpg

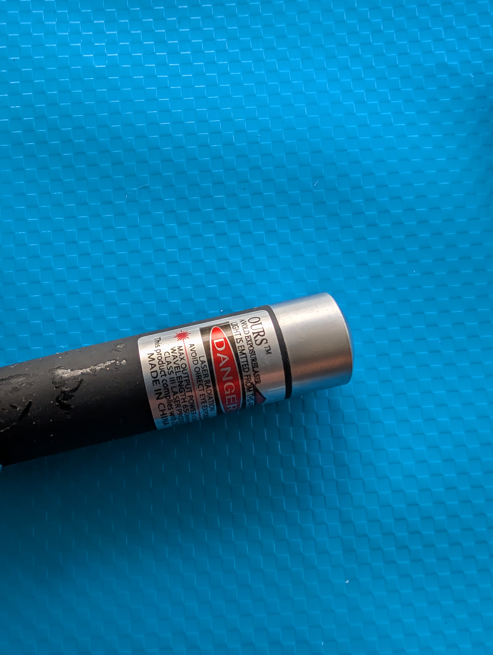
photos/PXL_20261003_113854789.jpg
