robsaddler/BreakBeam/photos/PXL_20261003_114113928.jpg

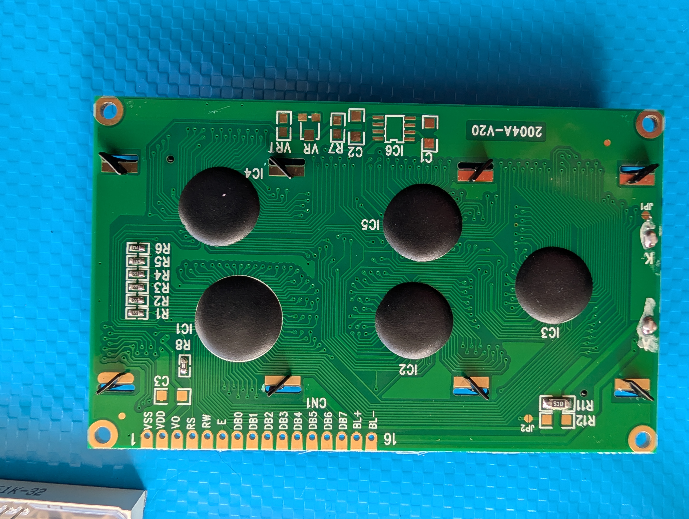
photos/PXL_20261003_114113928.jpg
