robsaddler/BreakBeam/photos/PXL_20261003_132724068.jpg

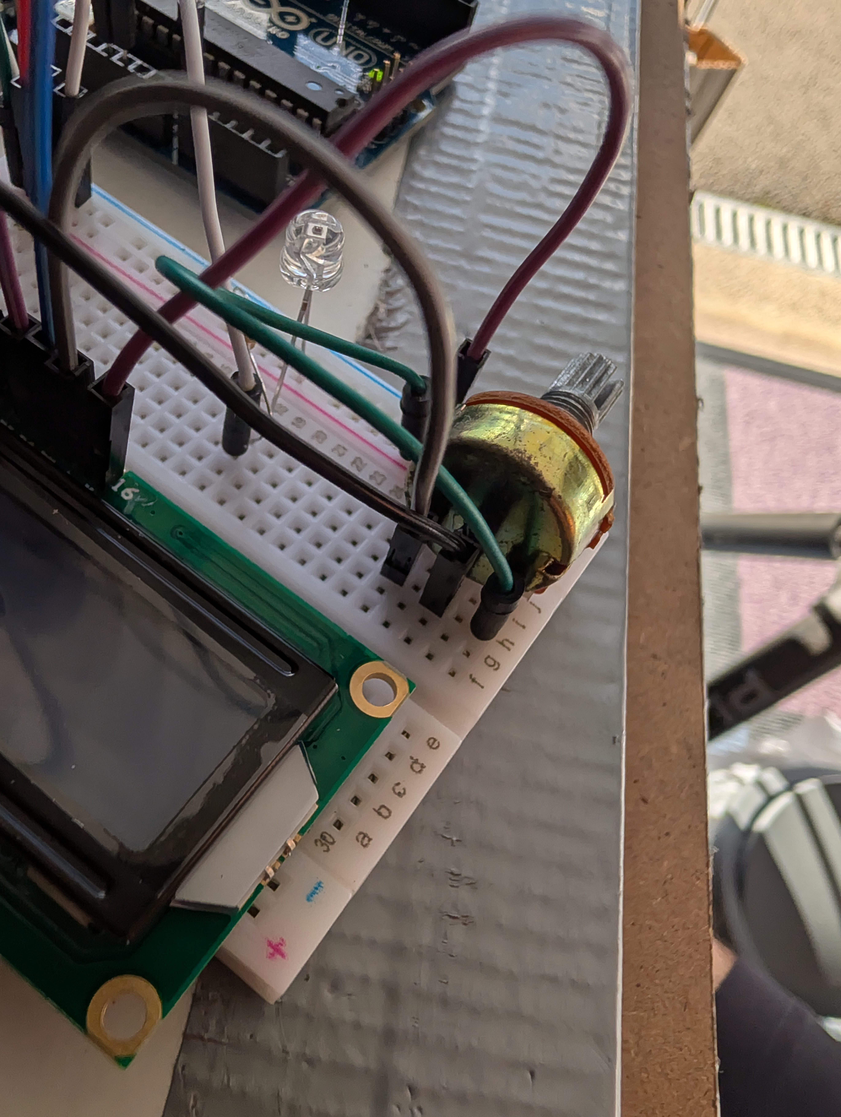
photos/PXL_20261003_132724068.jpg
