robsaddler/BreakBeam/photos/PXL_20261003_132727979.jpg

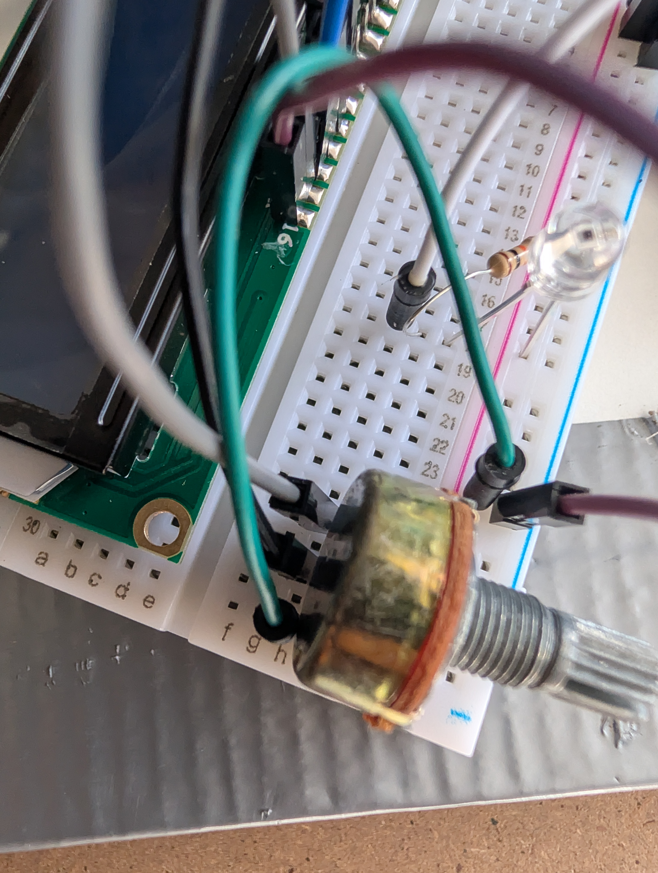
photos/PXL_20261003_132727979.jpg
