robsaddler/BreakBeam/photos/PXL_20261003_133159232.jpg

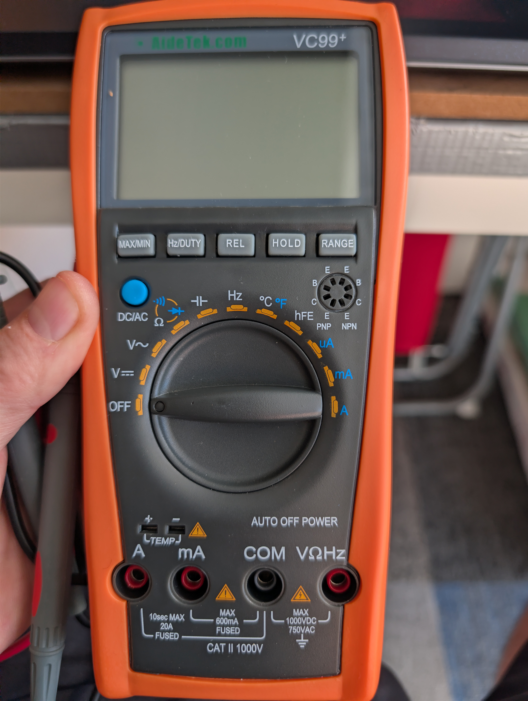
photos/PXL_20261003_133159232.jpg
