robsaddler/BreakBeam/photos/PXL_20261003_140347883.jpg

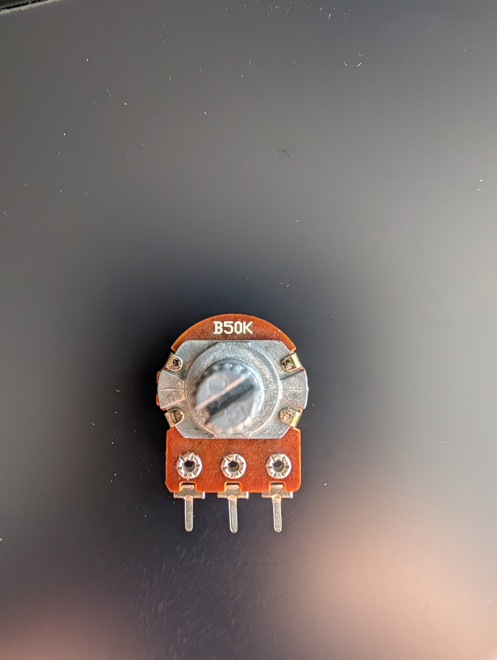
photos/PXL_20261003_140347883.jpg
