robsaddler/BreakBeam/photos/PXL_20261003_114105742.jpg

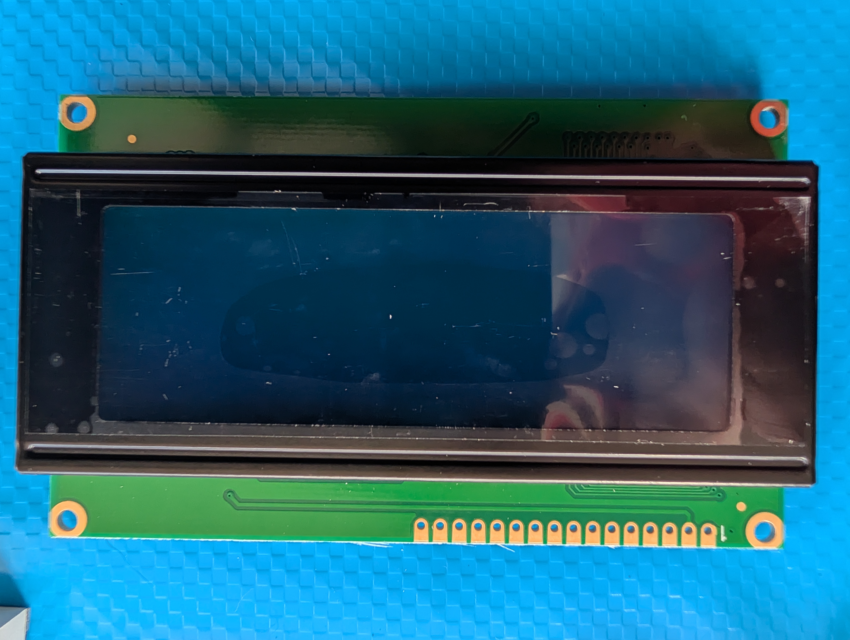
photos/PXL_20261003_114105742.jpg
