robsaddler/BreakBeam/photos/PXL_20261003_113525166.jpg

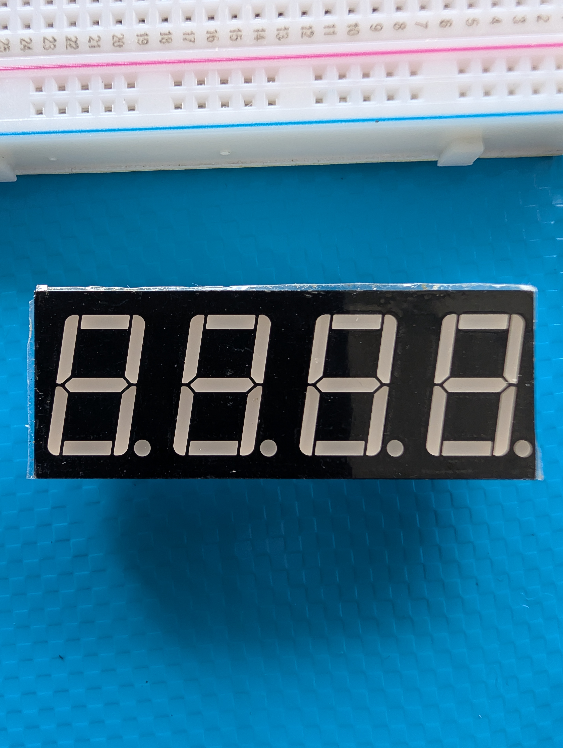
photos/PXL_20261003_113525166.jpg
